zyyang06/xyy/计划书.md

# 工作计划及时间安排

## 6.29

确定选题为基于STM32的直流电机驱动，且设计目标为用STM32实现一个能用按键、语音、APP控制开关与转速的风扇，列出后续的工作计划及时间安排。

## 6.30-7.2

  购买所需物料，学习完成该设计所需知识，创建工程文件并开始代码编写，完成相应的设计文档进行汇报。

## 7.2-7.9

  面包板/PCB板上测试电机驱动方案与其他外设，继续完善代码及设计文档。

# 物料清单

stm32单片机，面包板/PCB板、独立电源、蓝牙模块bt24、oled屏幕ssd1306、mpu6050、旋转编码器、stlink

# 分工

陈希： 主要负责完成工程文件中的代码编写和总体设计思路及框架。

黄泳仪：主要负责完成原理图以及PCB板的设计。

郑烨阳：主要负责完成设计文档编写以及辅助。
