zyyang06/xyy/PCB原理图.pdf

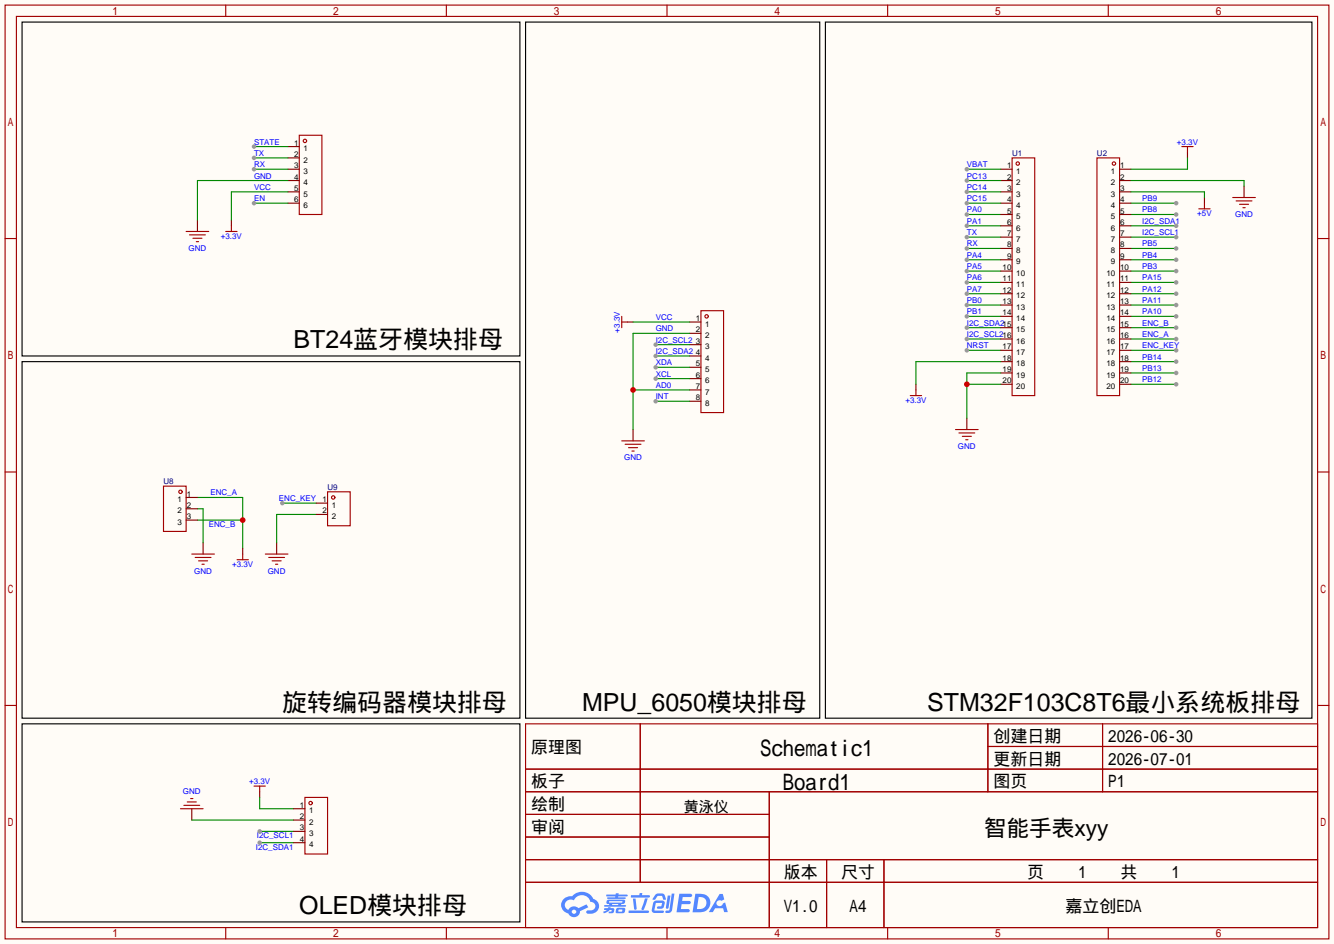
[picture p43: page 1]

原理图 | Schematic1 | 创建日期 | 2026-06-30

更新日期 | 2026-07-01

板子 | Board1 | 图页 | P1
绘制 | 黄泳仪 | 智能手表xyy
审阅

V1.0 | A4 | 嘉立创EDA
