zyyang06/xyy/蓝牙手表代码/Core/Inc/main.h

#define KEY2_Pin GPIO_PIN_5
#define KEY2_GPIO_Port GPIOA
#define KEY_Pin GPIO_PIN_6
#define KEY_GPIO_Port GPIOA
#define KnobBtn_Pin GPIO_PIN_15
#define KnobBtn_GPIO_Port GPIOB
