zyyang06/xyy/(commit log)

2026-07-06 Update 中期检查报告 with current progress and issues
2026-07-16 Revise system design document with progress updates
    Updated the system design document with hardware and software progress, including new images for PCB layout.
