zyyang06/xyy/(notices)

Notices in the files:
蓝牙手表代码/Core/Inc/main.h:
Copyright (c) 2026 STMicroelectronics.
All rights reserved.
This software is licensed under terms that can be found in the LICENSE file
